WSU-TurtleRabbit/mechanics/README.md

# TurtleRabbit mechanics

This is the home of the TurtleRabbit mechanics

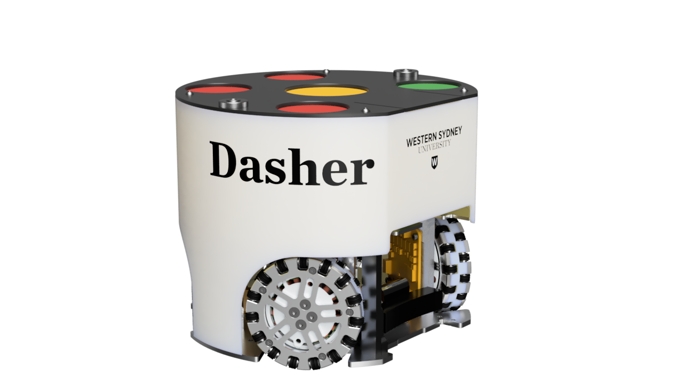
[picture p1: Render/rabbitbot_4wheel_v51.png]
The WSU SSL rabbit bot


designs, simulations, etc. for a RoboCup SSL robot model
