WSU-TurtleRabbit/mechanics/01-drive/Photos/drive-all_subwheels.jpg

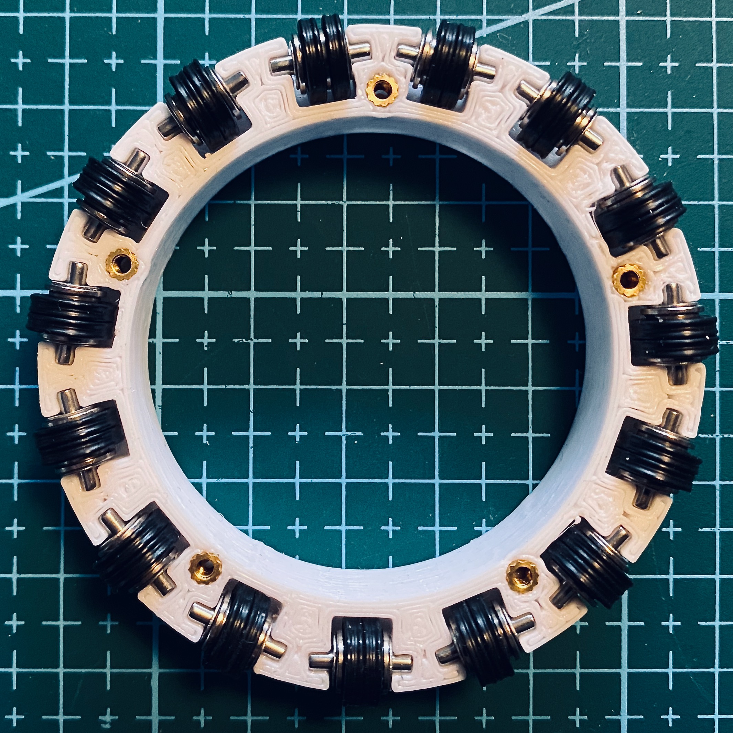
01-drive/Photos/drive-all_subwheels.jpg
