WSU-TurtleRabbit/mechanics/01-drive/Photos/drive-bolts.jpg

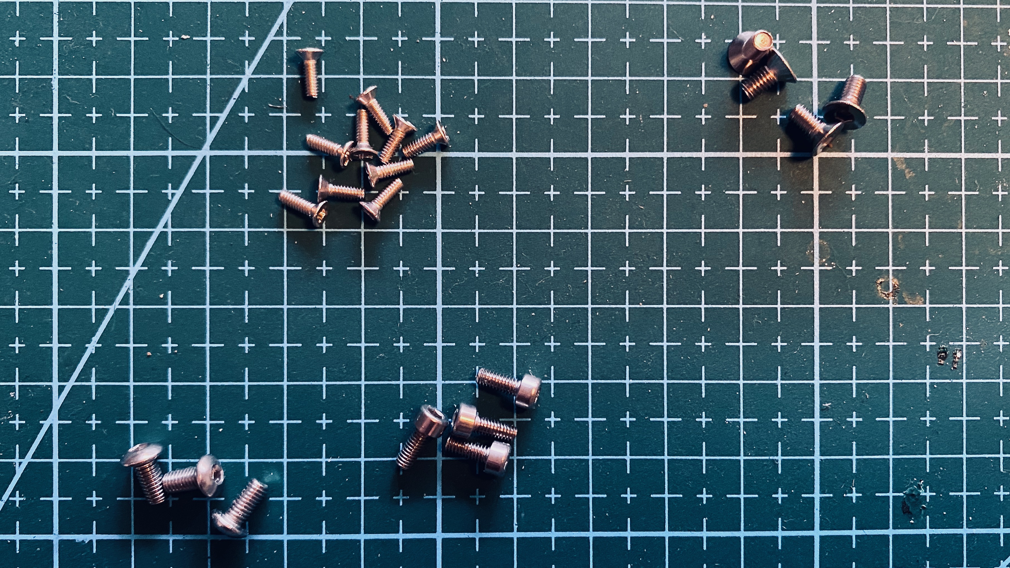
01-drive/Photos/drive-bolts.jpg
