WSU-TurtleRabbit/mechanics/01-drive/Photos/drive-chassis.jpg

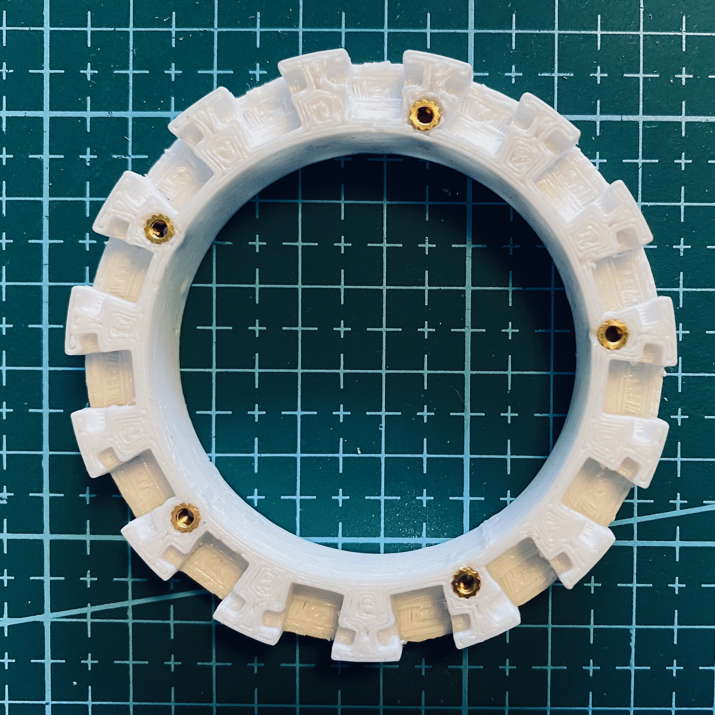
01-drive/Photos/drive-chassis.jpg
