WSU-TurtleRabbit/mechanics/01-drive/Photos/drive-completed.jpg

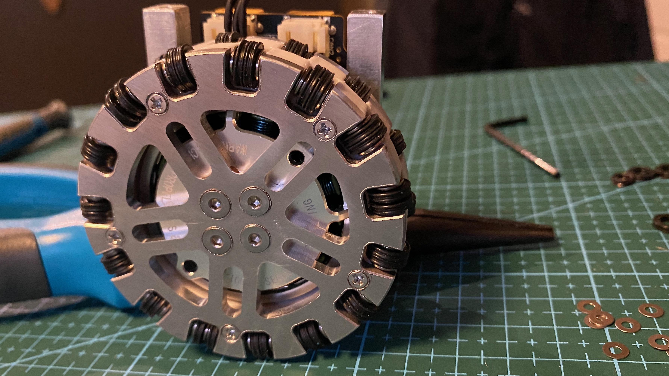
01-drive/Photos/drive-completed.jpg
