WSU-TurtleRabbit/mechanics/01-drive/Photos/drive-covers.jpg

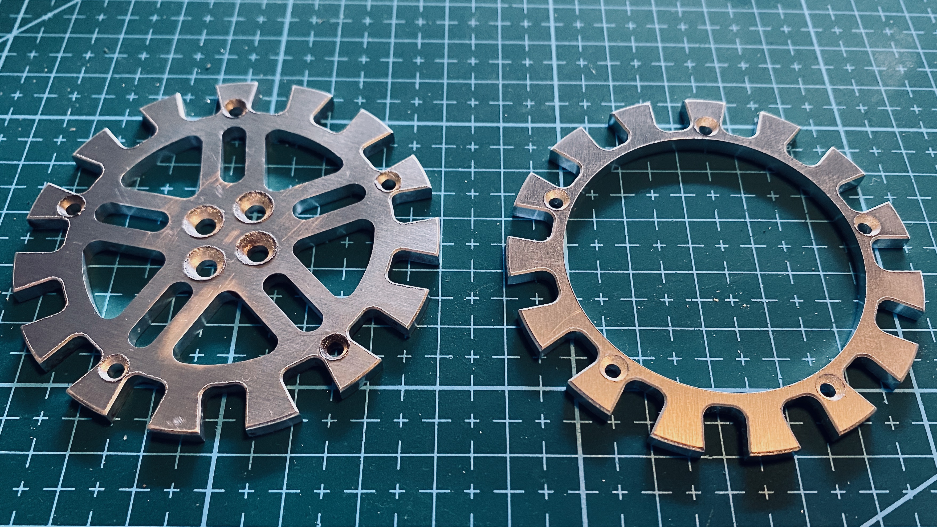
01-drive/Photos/drive-covers.jpg
