WSU-TurtleRabbit/mechanics/01-drive/Photos/drive-M2_inserts.jpg

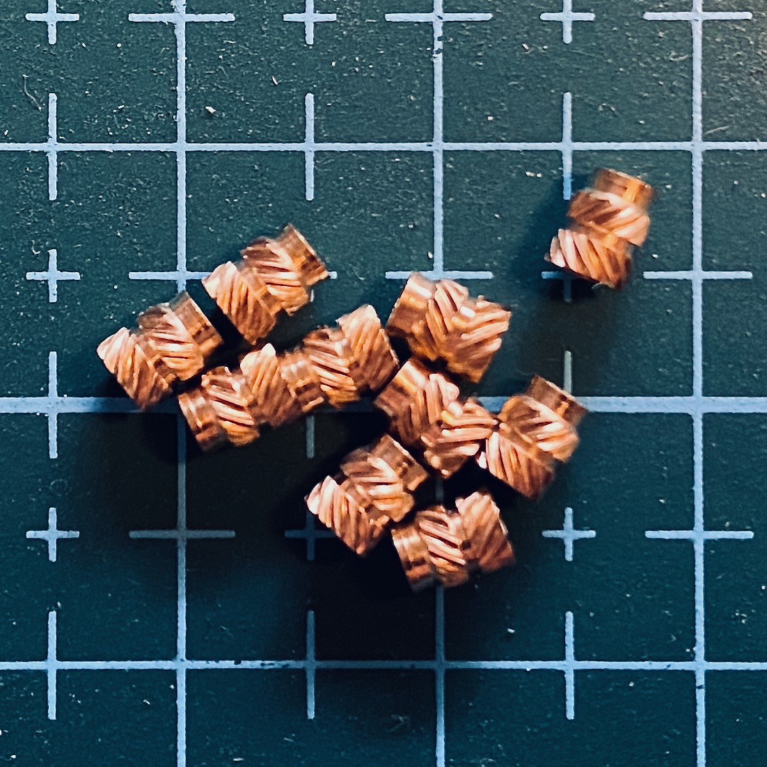
01-drive/Photos/drive-M2_inserts.jpg
