WSU-TurtleRabbit/mechanics/01-drive/Photos/drive-M2_washer.jpg

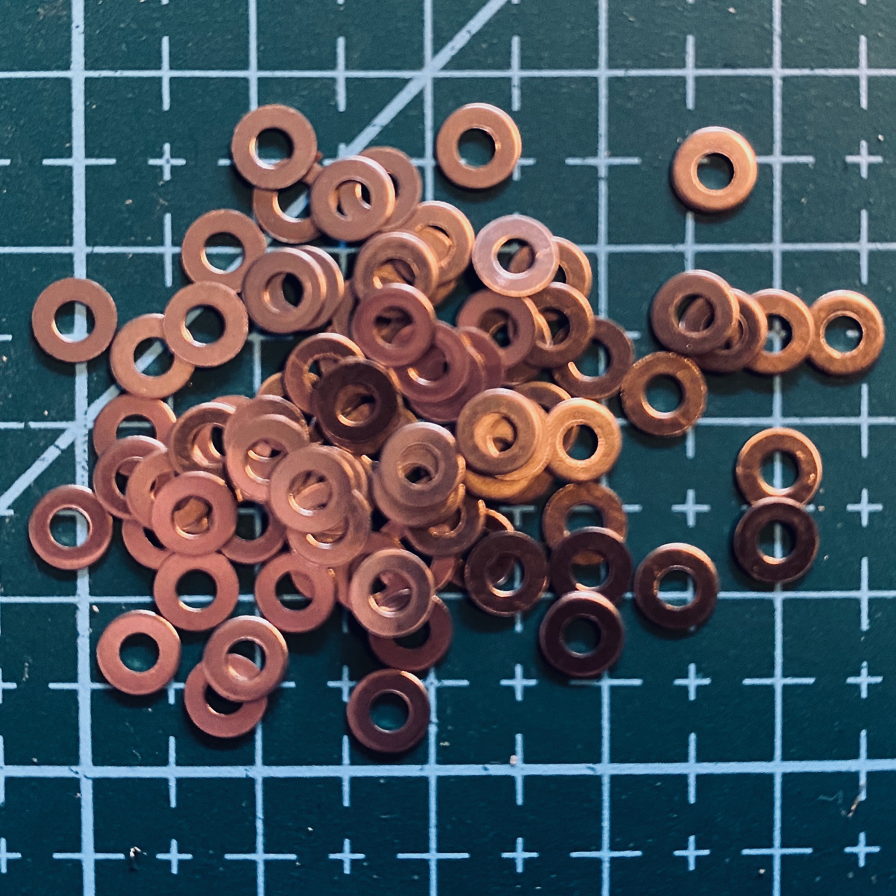
01-drive/Photos/drive-M2_washer.jpg
