WSU-TurtleRabbit/mechanics/01-drive/Photos/drive-MF52ZZ.jpg

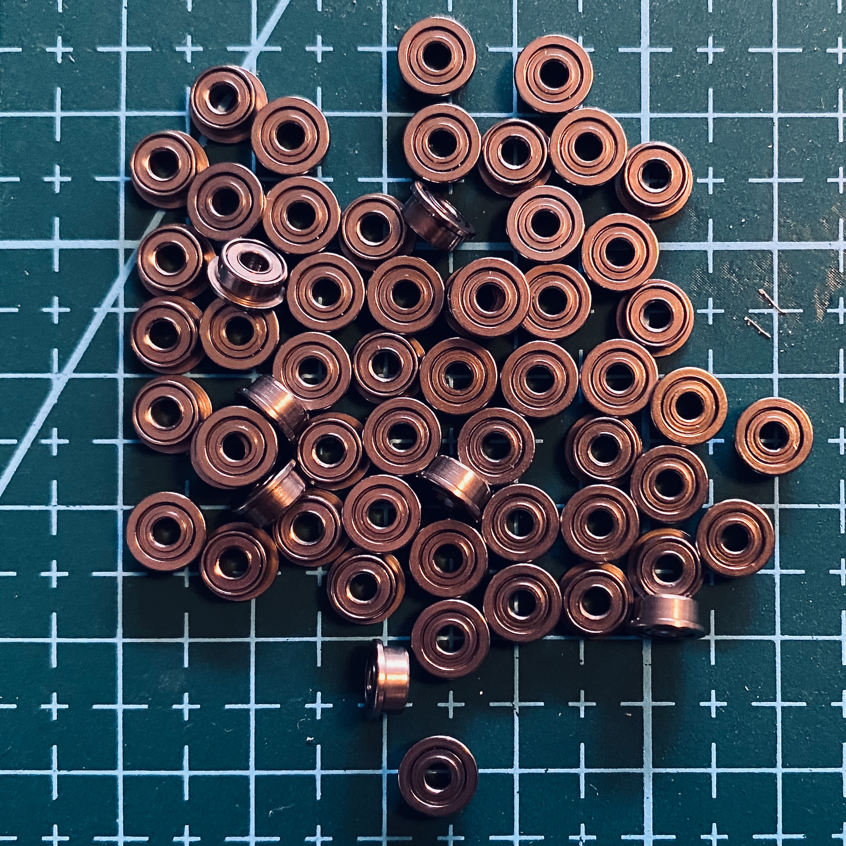
01-drive/Photos/drive-MF52ZZ.jpg
