WSU-TurtleRabbit/mechanics/01-drive/Photos/drive-moteus.jpg

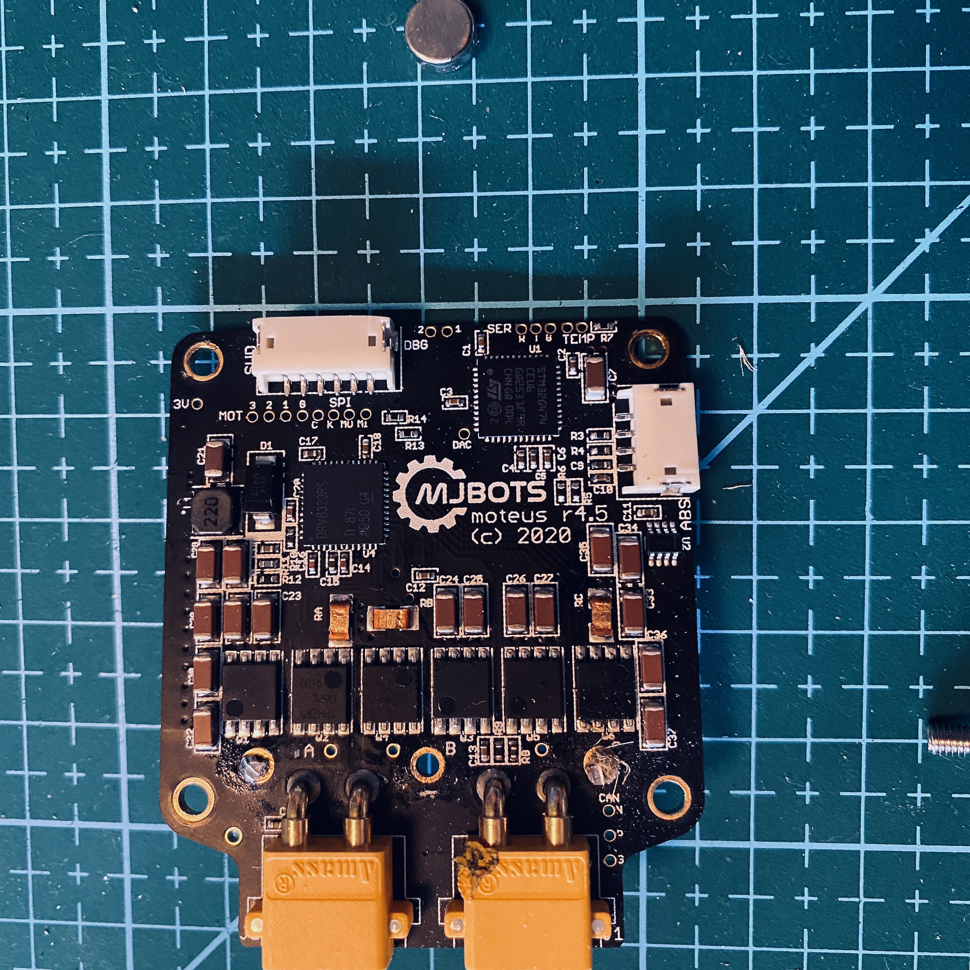
01-drive/Photos/drive-moteus.jpg
