WSU-TurtleRabbit/mechanics/01-drive/Photos/drive-motormount.jpg

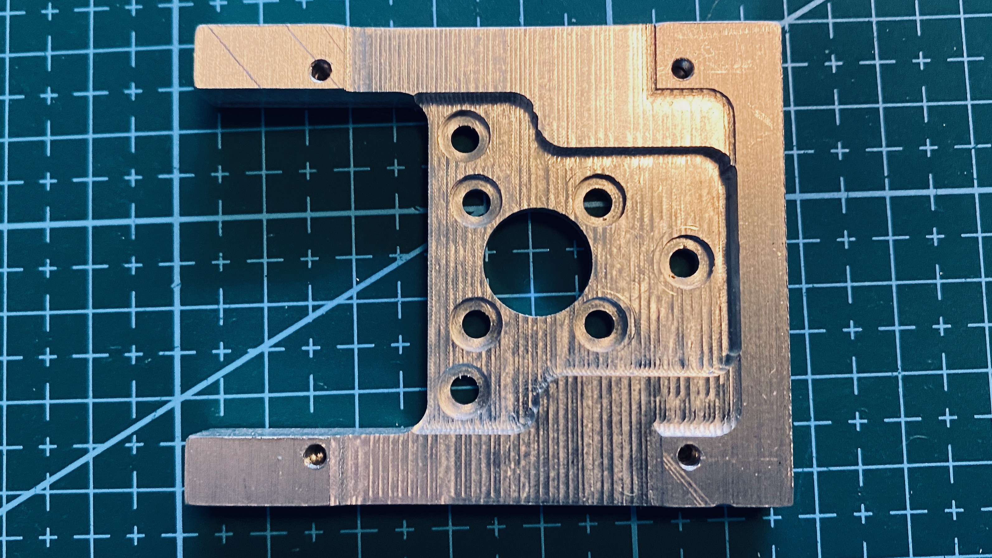
01-drive/Photos/drive-motormount.jpg
