WSU-TurtleRabbit/mechanics/01-drive/Photos/drive-rear_view.jpg

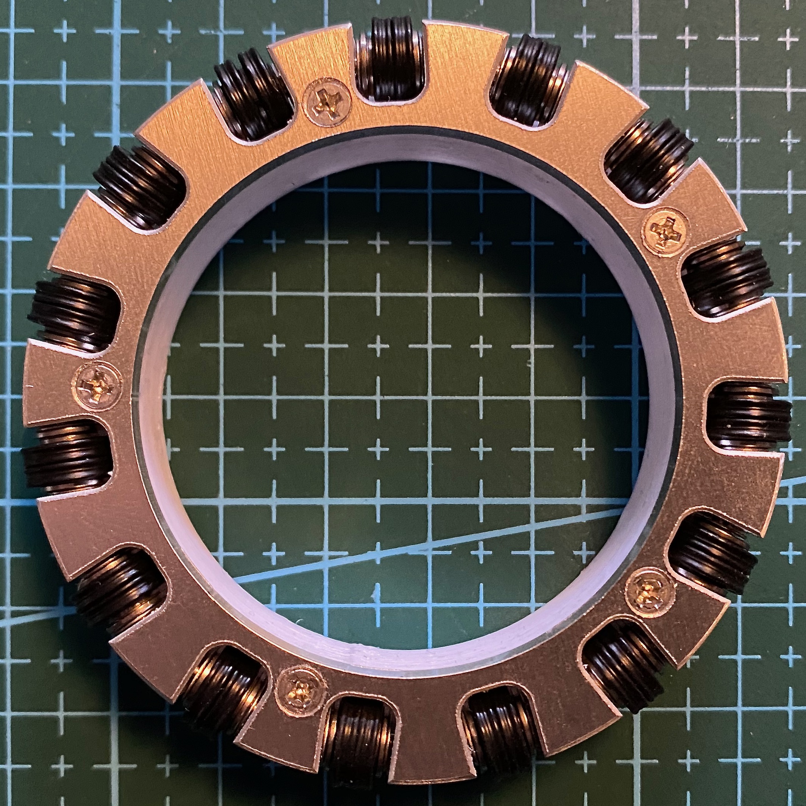
01-drive/Photos/drive-rear_view.jpg
