WSU-TurtleRabbit/mechanics/01-drive/Photos/drive-subwheel.jpg

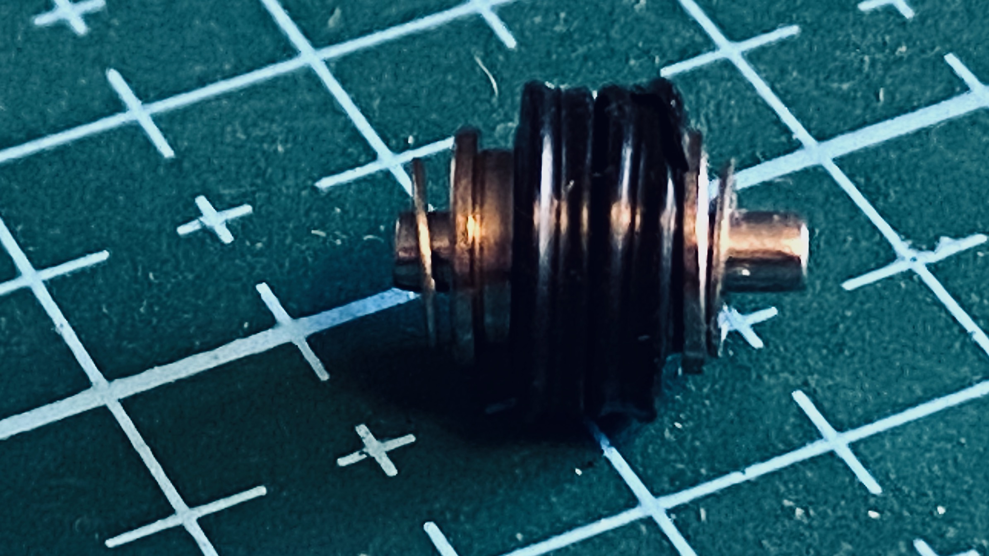
01-drive/Photos/drive-subwheel.jpg
