WSU-TurtleRabbit/mechanics/01-drive/Photos/drive-tarot4008.jpg

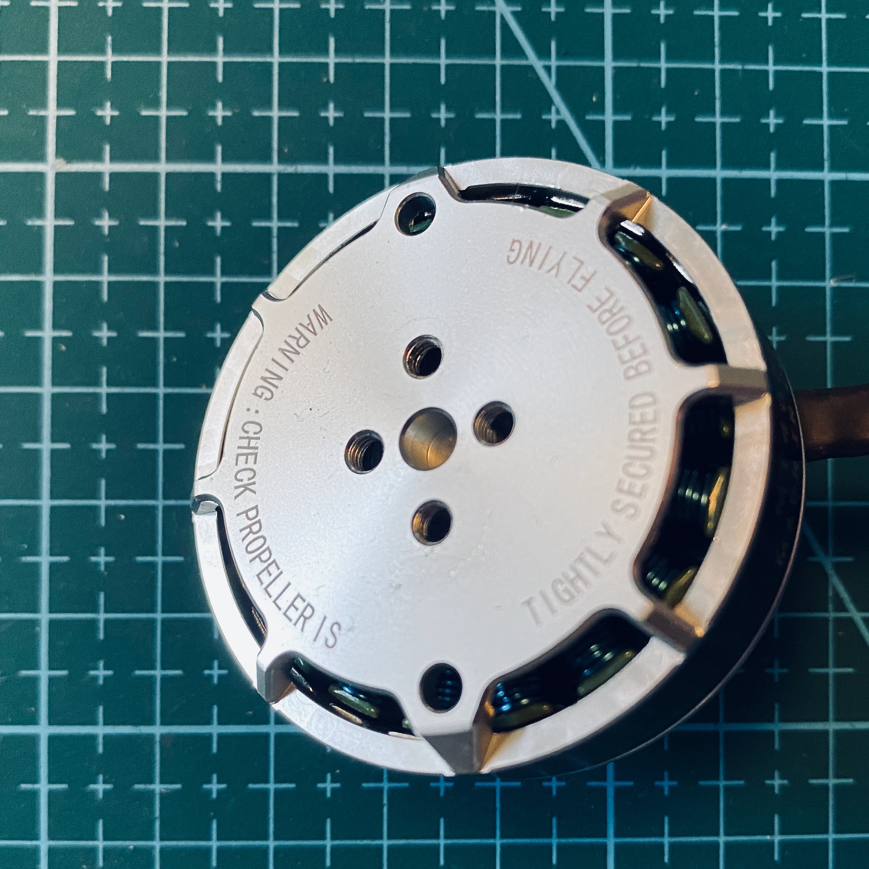
01-drive/Photos/drive-tarot4008.jpg
