WSU-TurtleRabbit/mechanics/01-drive/Photos/drive-xrings.jpg

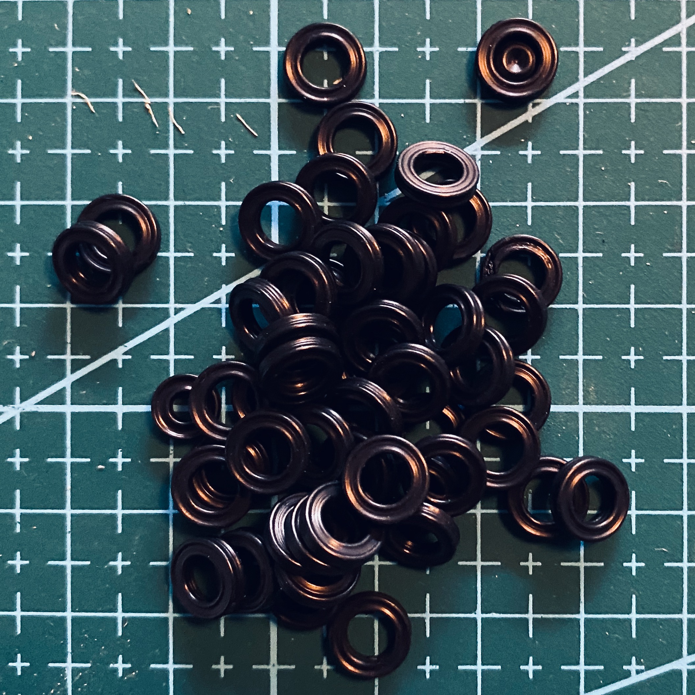
01-drive/Photos/drive-xrings.jpg
