WSU-TurtleRabbit/mechanics/Render/rabbitbot-2023-Sep-20.png

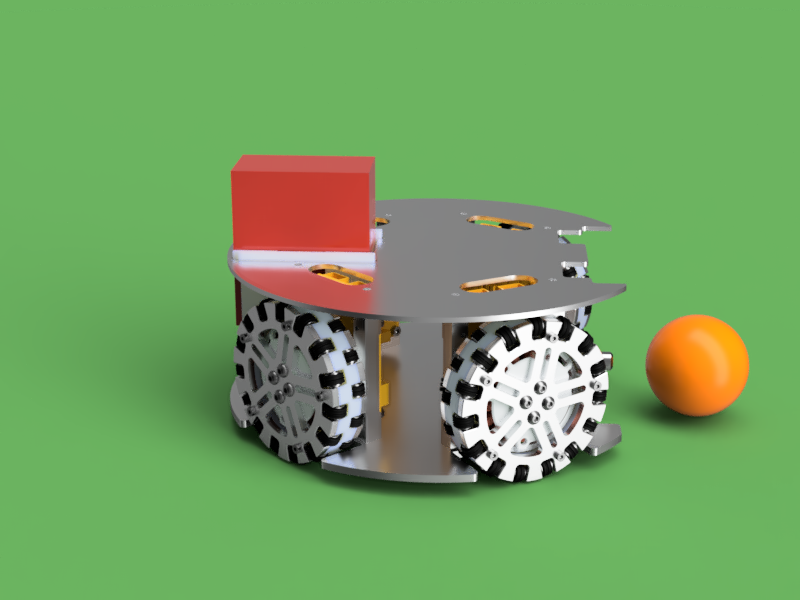
Render/rabbitbot-2023-Sep-20.png
