WSU-TurtleRabbit/mechanics/01-drive/BOM.md

BOM (prices in AUD unless stated otherwise).
- USD ~ 1.58 (4 Nov 23)

Prices exclude shipping costs and import taxes.

| Item | Qty Required | Pack Size | Unit Price | Total Price | Purchase Link |
|---|---:|---:|---:|---:|---|
| Tarot 4008 Martin BLDC Motor | 1 | 1 | 67.00 | 67.00 | [AliExpress](https://www.aliexpress.com/item/32697306634.html) | 
| MJBots Moteus R4 board | 1 | 1 |  US$104.00 | 160.00 | [MJBots](https://mjbots.com/products/moteus-r4-11) |
| MF52ZZ bearing 2x5x2.5 mm | 60 | 50 | 0.44 | 26.40 | [AliExpress](https://www.aliexpress.com/item/32890935741.html) |
| X-Ring NBR ID 4.47 x 1.78mm | 60 | 50 | 0.3  | 18.00 | [AliExpress](https://www.aliexpress.com/item/1005004320239343.html) |
| M2x10 Stainl. Steel Dowel Pins | 30 | 200 | 0.09 | 2.70 | [AliExpress](https://www.aliexpress.com/item/32457806478.html) |
| M2x5x0.3 SS flat round washer  | 60 | 200 | 0.01 | 0.60 | [Fastener Factory](https://www.thefastenerfactory.com.au/bolts-and-nuts/complete-washer-range/stainless-washers/stainless-flat-washers/stainless-steel-flat-round-washer-din125a-m2-x-5-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) |
| M2x4x3.2 heat set inserts | 10 | 600 | 0.03 | 0.30 | [AliExpress](https://www.aliexpress.com/item/1005004629326869.html) |
| 6061 Aluminium 100x100x3 | 2 | 5 | 5.00 | 10.00 | [AliExpress](https://www.aliexpress.com/item/1005005754654137.html) |
| 6061 Aluminium 7.94x50x62 | 1 | 32 | 10.12 | 10.12 | [Calm Aluminium](http://www.calm-aluminium.com.au/), Minto NSW |
| M2x6 SS CSK phillips / socket  | 10 | 100 | 0.03 | 0.30 | [Fastener Factory](https://www.thefastenerfactory.com.au/bolts-and-nuts/bolts-threaded-screws/machine-screws-sems/stainless-countersunk-threads/stainless-steel-countersunk-csk-phillips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) |
| M2.5x6 SS Hex socket head | 4 | 100 | 0.05 | 0.20 | [Fastener Factory](https://www.thefastenerfactory.com.au/bolts-and-nuts/bolts-threaded-screws/cap-head-allen-screws/stainless-hex-socket-cap-screws/stainless-steel-hex-socket-head-cap-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) |
| M3x6 SS CSK socket head | 4 | 100 | 0.07 | 0.28 | [Fastener Factory](https://www.thefastenerfactory.com.au/stainless-steel-csk-countersunk-socket-head-cap-screw-a4-316-m3-x-6mm-100pc) |
| M3x6 SS button head | 3 | 100 | 0.04 | 0.12 | [Fastener Factory](https://www.thefastenerfactory.com.au/bolts-and-nuts/bolts-threaded-screws/cap-head-allen-screws/stainless-button-socket-head-cap-screws/stainless-steel-button-socke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) |

The total price for one rabbit drive is approx. $300, including the moteus controller.
Prices on AliExpress were correct at the time of writing this, these prices often change.
