WSU-TurtleRabbit/mechanics/01-drive/Photos/drive-printed_parts.jpg

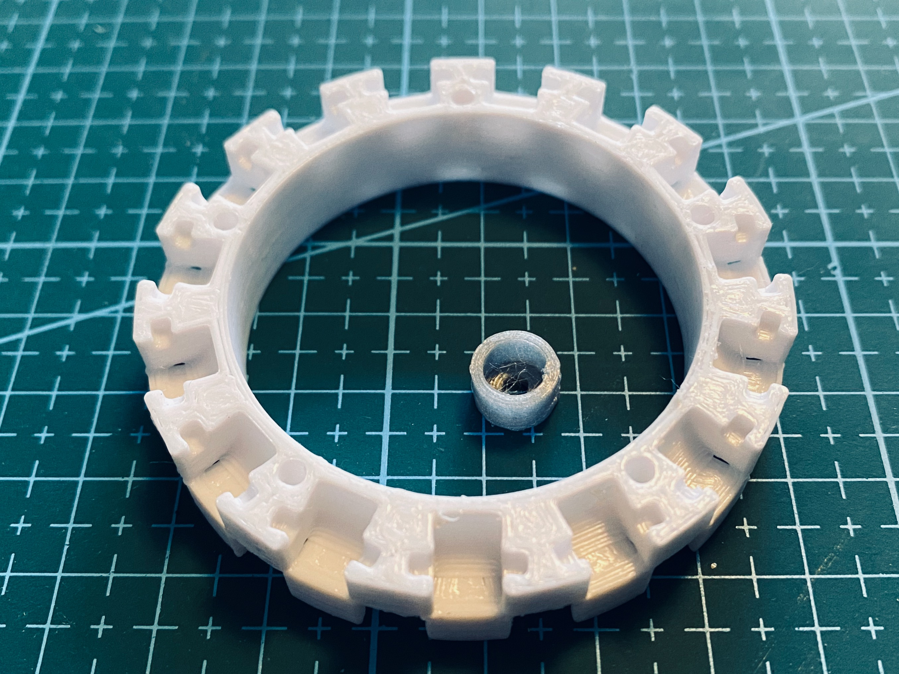
01-drive/Photos/drive-printed_parts.jpg
