WSU-TurtleRabbit/mechanics/03-dribbler/dribbler_assembly.STEP

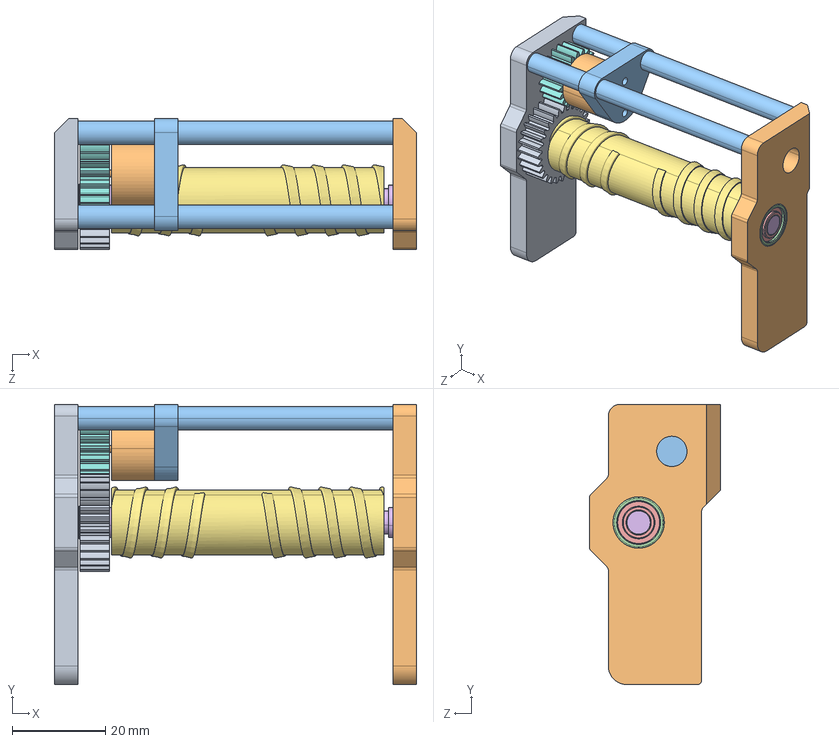
[picture p25: CAD file, 2023-12-08]
03-dribbler/dribbler_assembly.STEP
77.5 x 60.0 x 28.0 mm
dribbler_side_right
dribbler_side_left
dribbler_side_connector x 2
ball bearing 685-ZZ x 2
dribbler_roller_shaft
dribbler_roller
dribbler_input_gear
dribbler_output_gear
RCINPOWER GTS V3 1003 Motor
dribbler_motor_mount
