WSU-TurtleRabbit/mechanics/01-drive/STEP/motor mount tarot 4008 7-hole.step

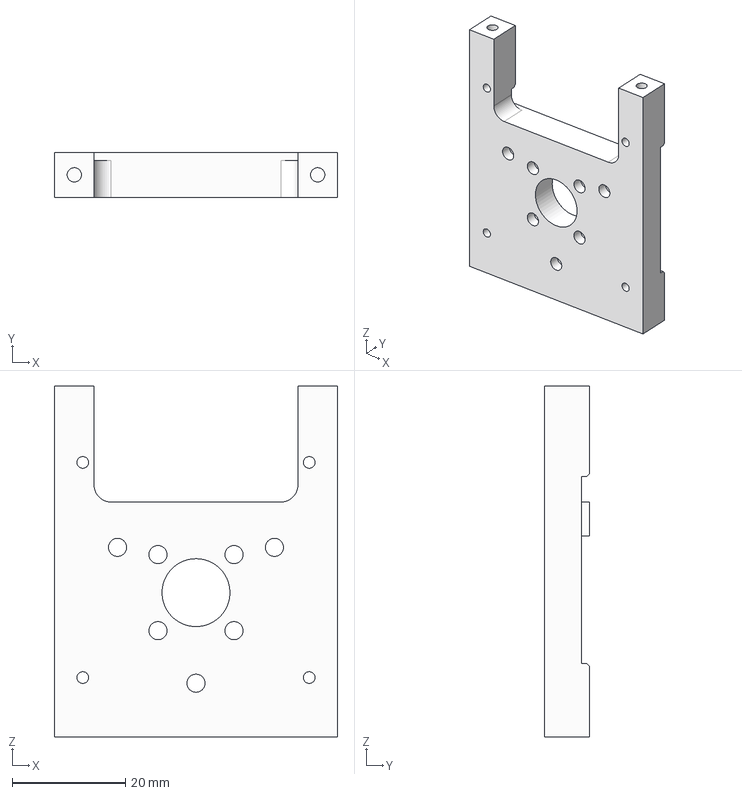
[picture p26: CAD file, 2025-02-26]
01-drive/STEP/motor mount tarot 4008 7-hole.step
50.0 x 7.94 x 62.0 mm
