WSU-TurtleRabbit/mechanics/01-drive/STL/motor_mount.stl

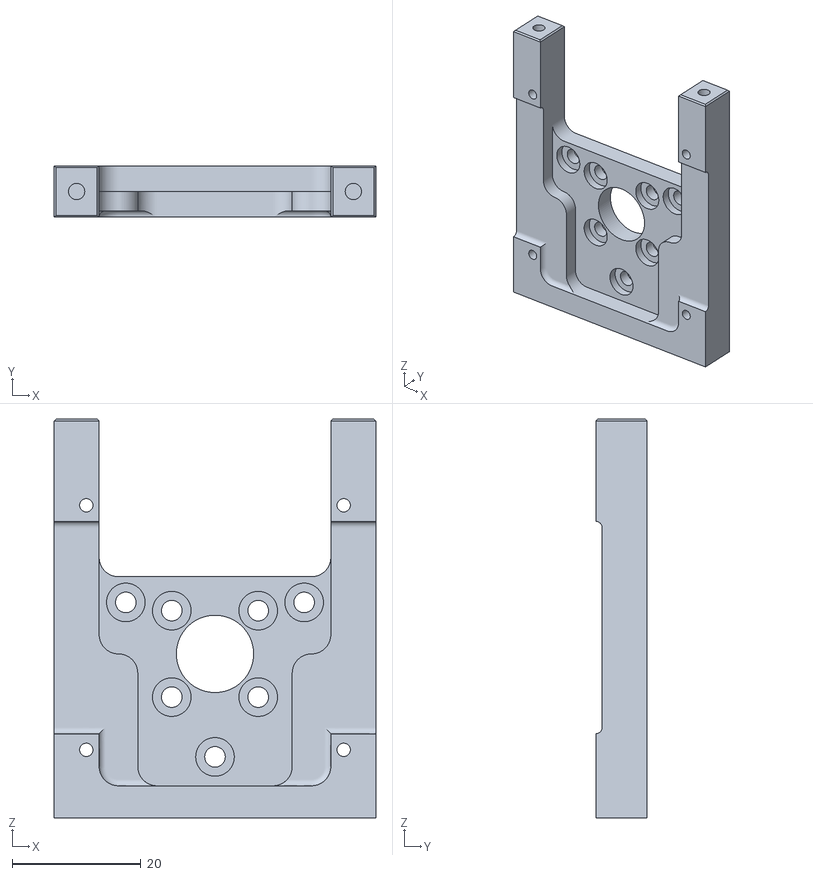
[picture p27: CAD file, 2023-09-20]
01-drive/STL/motor_mount.stl
50.0 x 8.00 x 62.0
