WSU-TurtleRabbit/mechanics/02-kicker/STEP/kicker.step

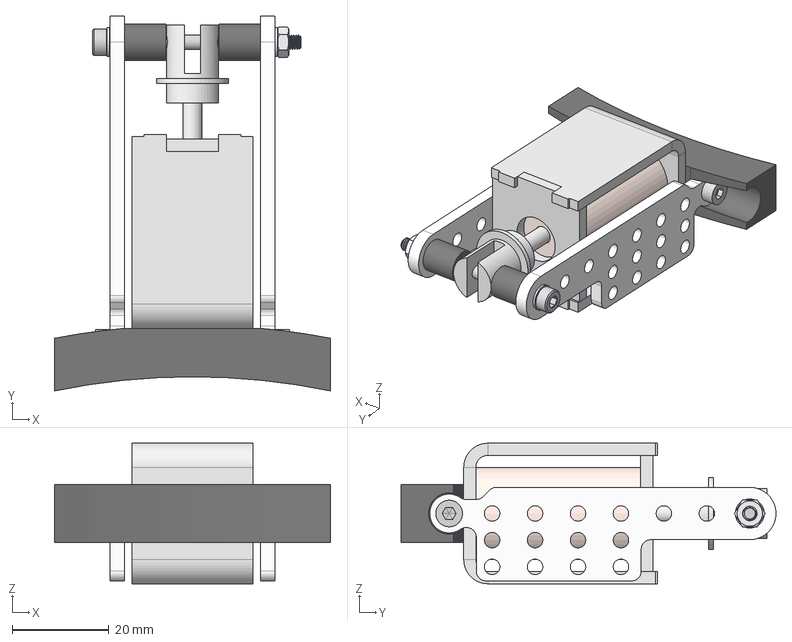
[picture p28: CAD file, 2023-12-08]
02-kicker/STEP/kicker.step
57.0 x 77.3 x 29.0 mm
M3x4.5x5 Heat-Set Insert 94459A130 x 2
ubracket
coil
slug
kicker guide x 2
M3x40 Socket Head Screw 18-8 Stainless Steel 91292A024
Washer DIN 433-1 - 3.2 - A Steel 100 HV Plain v1 x 2
Hexagon Nut DIN 934 - M3 x 0.5 Steel 6 Plain v1
Socket Head Cap Screw JIS B 1176 - M3 x 0.5 x 6 Steel 4.6 Plain v1 x 2
spacer
spacer(Mirror)
