WSU-TurtleRabbit/mechanics/02-kicker/STL/spacer.stl

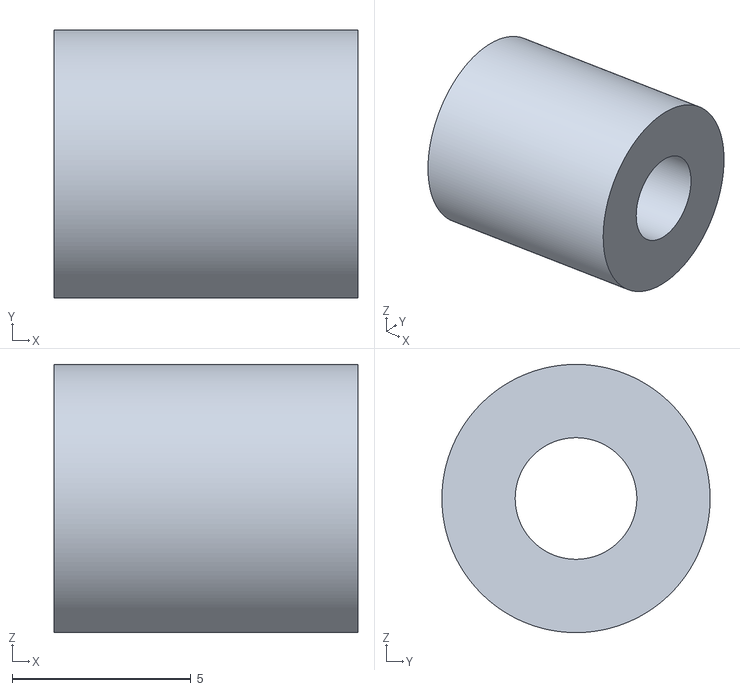
[picture p29: CAD file, 2023-12-08]
02-kicker/STL/spacer.stl
8.50 x 7.50 x 7.50
