WSU-TurtleRabbit/mechanics/04-electronics/STEP/platelevel1.step

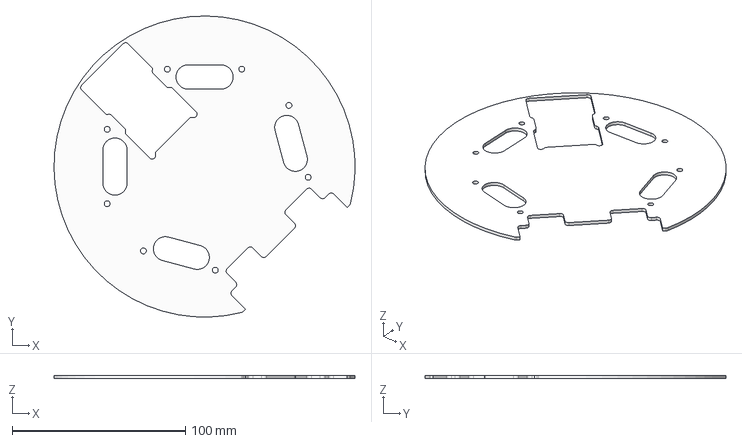
[picture p30: CAD file, 2023-12-08]
04-electronics/STEP/platelevel1.step
173.9 x 173.9 x 2.00 mm
