WSU-TurtleRabbit/mechanics/04-electronics/STL/battery_holder.stl

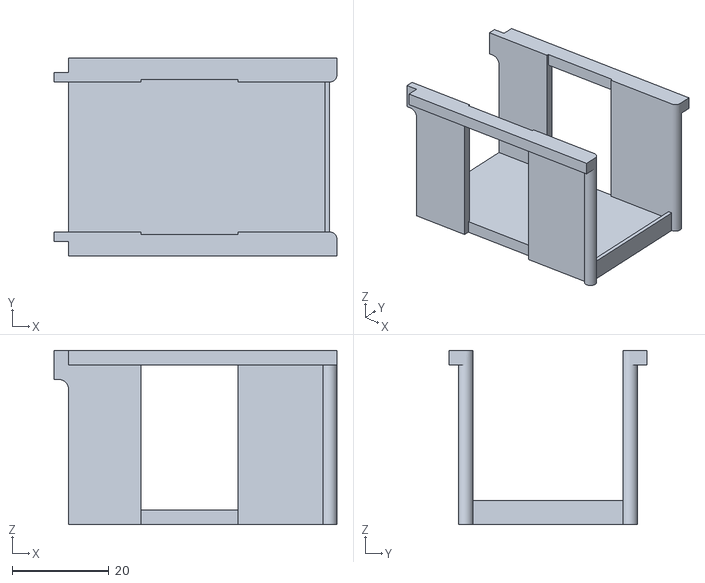
[picture p31: CAD file, 2023-12-08]
04-electronics/STL/battery_holder.stl
58.5 x 41.0 x 36.0
