WSU-TurtleRabbit/mechanics/01-drive/STEP/magnet_holder.step

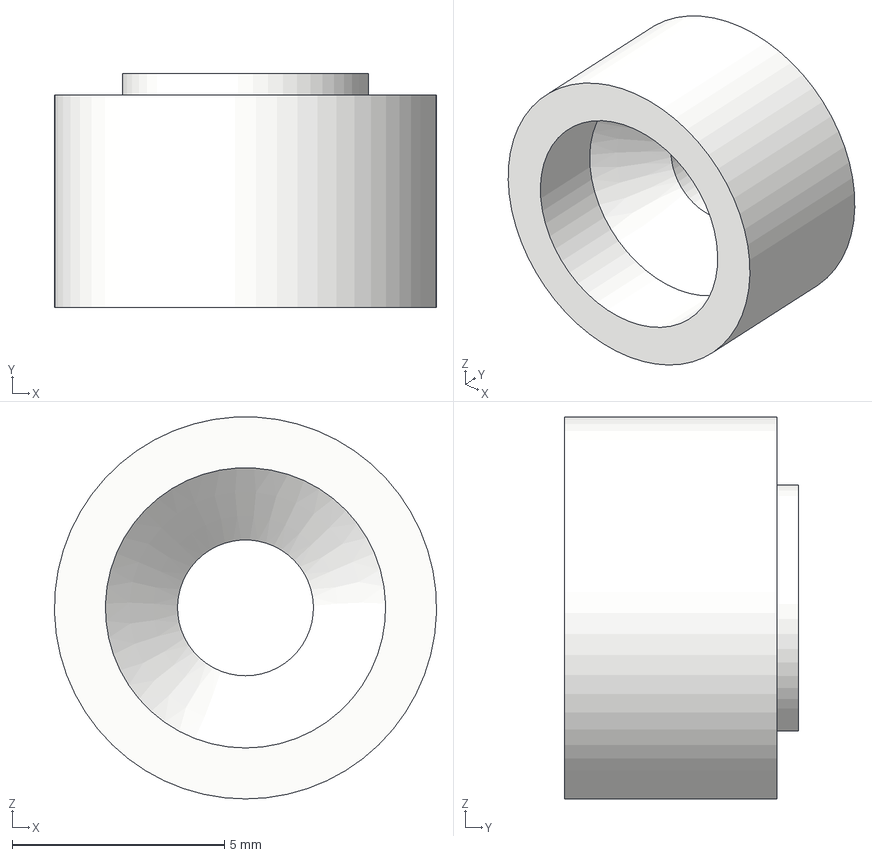
[picture p32: CAD file, 2023-12-08]
01-drive/STEP/magnet_holder.step
9.00 x 5.50 x 8.99 mm
