WSU-TurtleRabbit/mechanics/02-kicker/STEP/solenoid.step

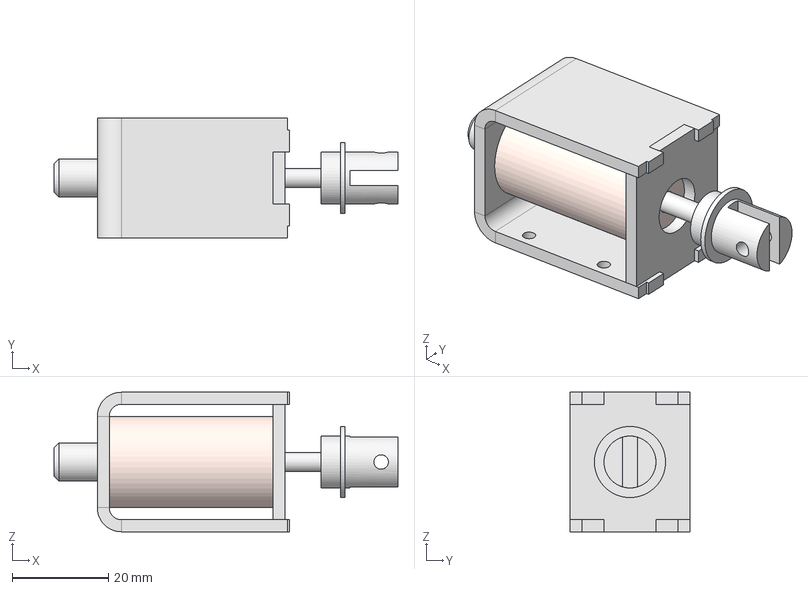
[picture p33: CAD file, 2023-11-23]
02-kicker/STEP/solenoid.step
71.5 x 25.0 x 29.0 mm
ubracket
coil
slug
