WSU-TurtleRabbit/mechanics/02-kicker/STL/kickerhead.stl

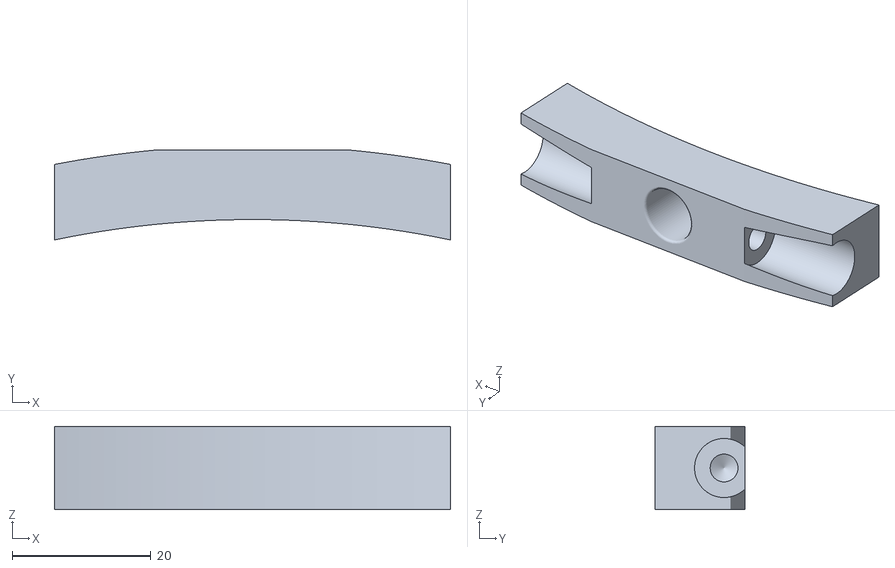
[picture p34: CAD file, 2023-12-08]
02-kicker/STL/kickerhead.stl
57.0 x 12.9 x 12.0
