WSU-TurtleRabbit/mechanics/01-drive/STEP/rear_cover.step

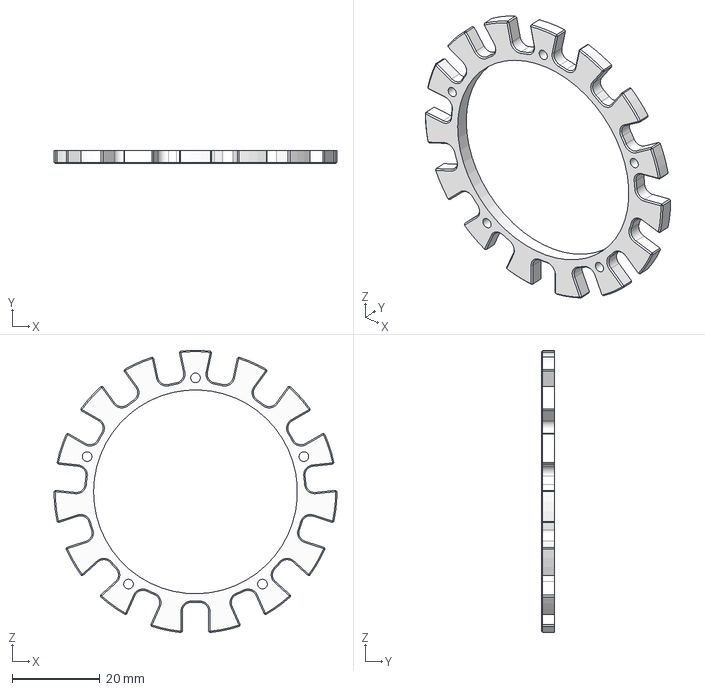
[picture p36: CAD file, 2023-09-20]
01-drive/STEP/rear_cover.step
64.6 x 3.00 x 64.4 mm
