WSU-TurtleRabbit/mechanics/01-drive/STEP/wheel_chassis.step

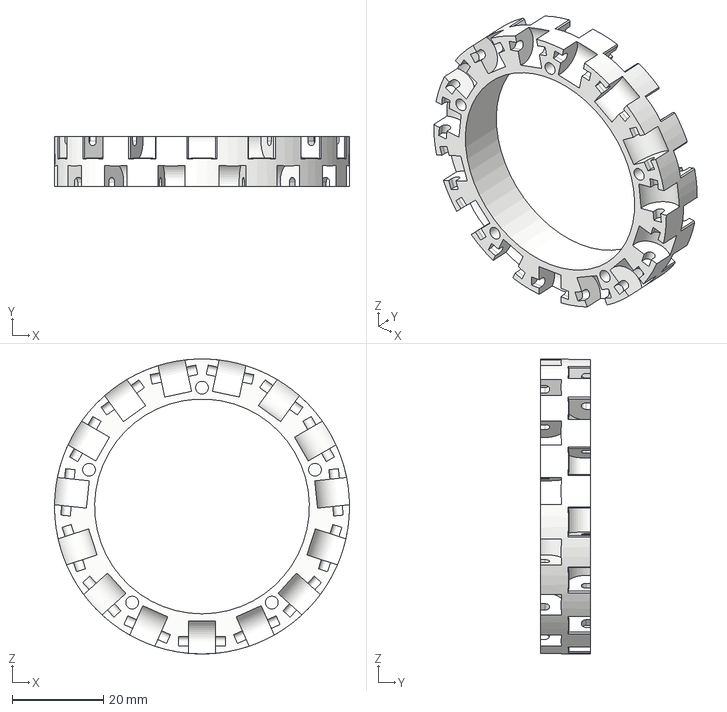
[picture p37: CAD file, 2023-09-20]
01-drive/STEP/wheel_chassis.step
64.6 x 11.0 x 64.5 mm
