WSU-TurtleRabbit/mechanics/(list of files, cad)

Other CAD files:
01-drive/STL/front_cover.stl
01-drive/STL/magnet_holder.stl
01-drive/STL/rear_cover.stl
01-drive/STL/wheel_chassis.stl
