WSU-TurtleRabbit/mechanics/01-drive/PDF/motor mount tarot 4008 7-hole Drawing.pdf

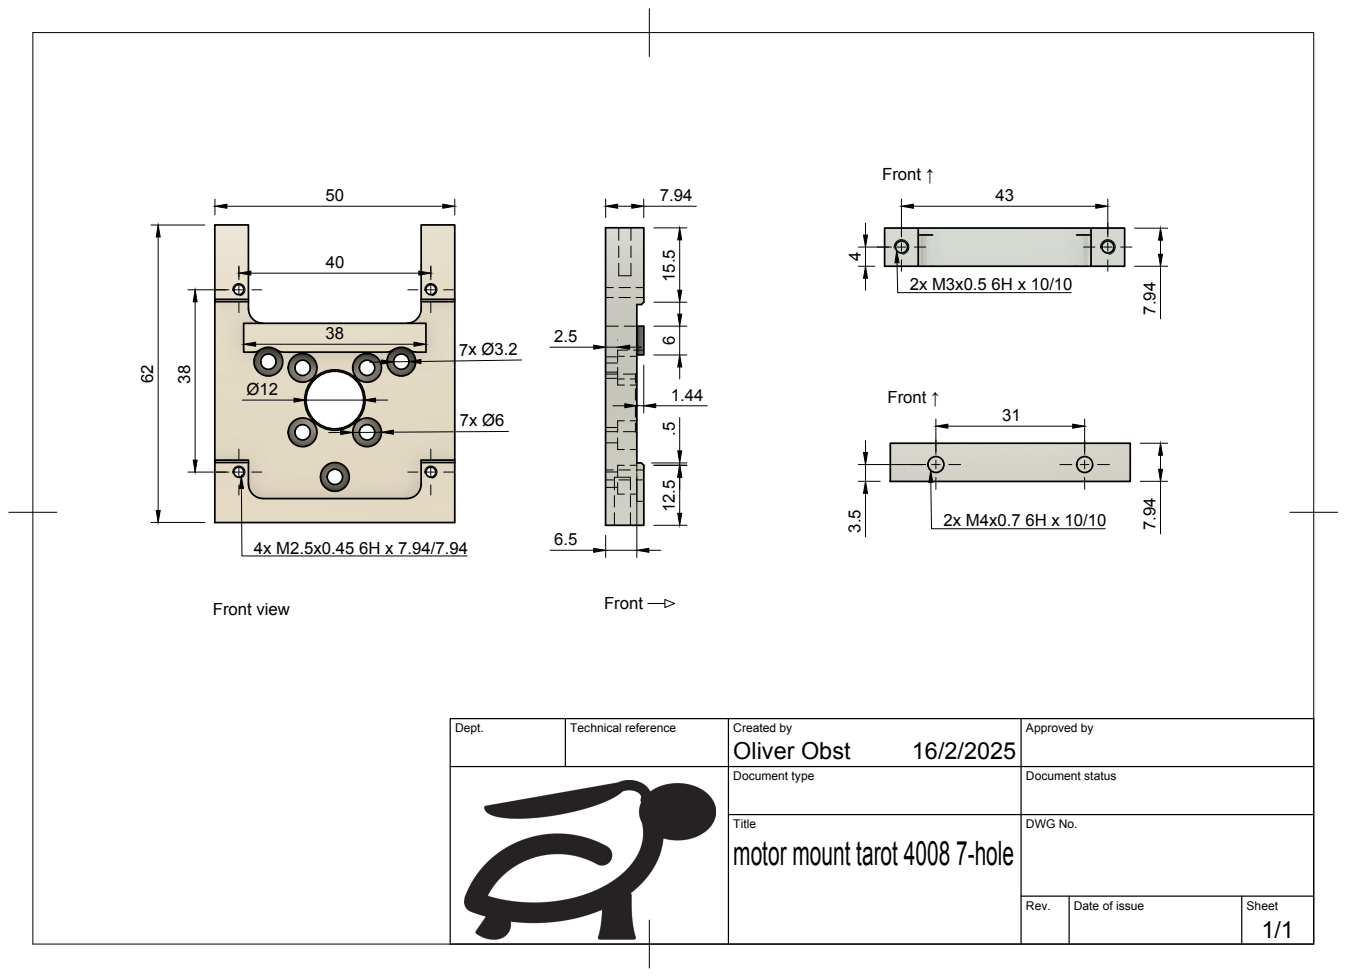
[picture p38: page 1]
Front view; Front; Front ↑

Dept. | Technical reference | Created by Oliver Obst 16/2/2025 | Approved by

Document type | Document status

Title motor mount tarot 4008 7-hole | DWG No.

Rev. | Date of issue | Sheet 1/1
