WSU-TurtleRabbit/mechanics/(commit log)

2023-09-20 rabbit wheel initial commit
    [front_cover.step, front_cover.stl, magnet_holder.step, magnet_holder.stl, motor_mount.step, motor_mount.stl, rear_cover.step, rear_cover.stl]
2023-09-20 added render of motormount
2023-10-03 new render of the current version
2023-10-19 I added something amazing
    [wheel_chassis.stl]
2023-11-04 added BOM
2023-11-23 add kicker
    [solenoid.step]
2023-12-02 Added dribbler
    [dribbler_assembly.STEP]
2023-12-08 added electronics step files and mechanical plans
    [battery_holder.stl, magnet_holder.step, magnet_holder.stl, platelevel1.step]
2023-12-08 added kicker step and STLs
    [kicker.step, kickerhead.stl, spacer.stl]
2025-02-26 added new motor mount version
    [motor mount tarot 4008 7-hole.step, motor_mount.step]
